BragaNux/IOT_N2/docs/Trabalho_N2_Caderno_de_Projeto.docx

Faculdade Antonio Meneghetti · Sistemas de Informação

IoT (Internet das Coisas) · G0813 · Prof. Leonam V. Hemann · Turma AMF 2026-02

TRABALHO N2 — CADERNO DE PROJETO

Da ideia ao sistema: decidir, montar e justificar

Integrantes (pode ser em dupla) papéis: montagem · código · nuvem e painel · caderno e testes | Brayan Martins · Mell Campos
Desafio escolhido | B — ideia própria: Ninho, chocadeira inteligente
Link do repositório no GitHub | https://github.com/BragaNux/IOT_N2

# COMO USAR ESTE CADERNO

Este caderno é ao mesmo tempo o roteiro do projeto e a entrega. Ele leva o grupo, etapa por etapa, pelas decisões que todo sistema IoT precisa tomar. Em cada etapa vocês encontram:

- Entenda: um resumo do que já vimos em aula, para ajudar a decidir.
- Decidam: os campos que o grupo preenche. Toda escolha vem com o porquê.

# COMO VAI SER AVALIADO

Critério | Etapas | Pontos
Ideia, problema e requisitos medíveis | 0 e 1 | 1,5
Sentir, decidir e agir funcionando, com estado seguro | 2 e 3 | 2,0
Comunicação: MQTT com TLS e padrão de tópicos | 4 | 1,5
Histórico com consulta de resumo | 5 | 1,0
Painel com comando confirmado e alerta com cooldown | 6 | 1,5
Segurança aplicada e testada | 7 | 1,0
Extra com evidência | 8 | 0,5
Arquitetura, testes e apresentação | 11 | 1,0
Total | | 10,0

# ETAPA 0 — ESCOLHAM O DESAFIO

Escolham um caminho: um dos desafios prontos (opção A) ou uma ideia própria (opção B). Vale montar na placa ou no Wokwi.

## Opção A — Desafios prontos

Desafio | O problema | Kit sugerido | A decisão mais difícil
Geladeira de vacinas | O posto guarda vacinas a 2–8 °C e precisa provar, pelo histórico, que elas nunca saíram da faixa. | DHT · distância (porta) · buzzer | O que fazer com as leituras se a internet cair?
Silo de grãos | Grão úmido estraga. O ventilador liga quando precisa, e não há tomada no silo. | DHT · LED ou relé (ventilador) | Quanto tempo o ESP32 pode ficar acordado para a bateria durar?
Armário de empréstimo | Laboratório: registrar quem pegou cada equipamento e quando devolveu. | botões (senha) ou RFID · servo (trava) · distância | Como impedir que alguém abra o armário com um comando falso?
Poste inteligente da praça | Luz forte só com gente perto. A prefeitura vê e comanda todos os postes de um painel. | LDR · distância ou PIR · LEDs (PWM) | Como organizar os tópicos para 100 postes?

## Opção B — Criem a ideia de vocês

Escolham (ou sorteiem) um item de cada coluna e transformem em um produto. A restrição é o que deixa a ideia interessante: ela obriga a tomar decisões de rede, energia ou segurança.

Lugar | Sensor | Atuador | Restrição
escola · fazenda · hospital · fábrica · rua · supermercado · academia · casa de idoso · estacionamento · biblioteca | LDR · DHT11 · LM35 · PIR · ultrassônico · RFID · umidade do solo · potenciômetro · botão | LED · LED RGB · buzzer · servo · relé · motor DC | sem Wi-Fi · bateria de 1 ano · dado sensível (LGPD) · 1.000 unidades · usuário sem celular · até R$ 60 · tem que funcionar sem internet · decidir em menos de 1 s

Frase da ideia: "Para [quem], que sofre com [problema], o [nome do produto] sente [sensor], decide [regra] e age com [atuador], mesmo com [restrição]."

## Decidam

Desafio (A) ou ideia própria (B) | B — ideia própria. Lugar: fazenda · Sensor: DHT22 (temperatura e umidade) · Atuador: relé (aquecedor), além de servo, buzzer e LED · Restrição: tem que funcionar sem internet.

Por que esse problema importa? Quem ganha com a solução? - Frase da ideia

O pequeno produtor rural que cria galinhas caipiras choca ovos numa chocadeira caseira (caixa de isopor + lâmpada). O embrião precisa de 37,5 °C estáveis por 21 dias, umidade controlada e ovos virados várias vezes por dia. Algumas horas de superaquecimento ou uma lâmpada queimada à noite perdem a ninhada inteira, e o produtor só descobre no dia 21. No interior, a internet é instável, então o sistema não pode depender dela para funcionar.

Quem ganha: o produtor (menos ovos perdidos, sem acordar de madrugada para conferir) e quem compra os pintinhos. O histórico mostra em que dia e por quanto tempo a chocadeira saiu da faixa, o que explica uma eclosão ruim.

Frase da ideia: "Para pequenos produtores rurais, que perdem ninhadas inteiras quando a chocadeira esquenta ou esfria sem ninguém ver, o Ninho sente a temperatura e a umidade (DHT22), decide quando aquecer, quando virar os ovos e quando alarmar, e age com o aquecedor (relé), o virador (servo) e a sirene (buzzer + LED), mesmo sem internet."

# ETAPA 1 — PROBLEMA E REQUISITOS

## Entenda

- Requisito funcional diz o que o sistema faz. Modelo: "O dispositivo deve [ação] quando [condição], em até [tempo ou limite]."
- Requisito não funcional diz como e quanto: energia, custo, rede disponível, ambiente (frio, umidade), tempo de resposta.
- Um bom requisito é medível: "alarme se T > 8 °C por mais de 5 min", e não "alarme se esquentar".

## Decidam

Código | Requisito (o dispositivo deve...) | Como vamos comprovar
RF1 | Medir temperatura e umidade a cada 2 s, publicar a telemetria a cada 30 s e gravar 1 leitura por minuto no histórico, com data e hora. | Log do Serial (2 s), mensagens MQTT a cada 30 s e 1 registro por minuto no D1.
RF2 | Controlar o aquecedor: ligar o relé quando T < 37,3 °C e desligar quando T > 37,7 °C (histerese), em até 2 s. | No Wokwi: DHT22 em 37,0 °C → lâmpada acende; 37,5 °C → mantém; 37,8 °C → apaga.
RF3 | Alarmar (buzzer + LED) se T ficar fora de 36,5–38,5 °C por mais de 2 min. Se T ≥ 39,5 °C, alarmar na hora e forçar o aquecedor desligado. | DHT22 em 39,0 °C → cronometrar 2 min até o alarme; em 40 °C → alarme e relé desligado em até 2 s.
RF4 | Virar os ovos (servo 45° ↔ 135°) a cada 1 h, e parar automaticamente a partir do dia 19 do ciclo. | Log do Serial com horário de cada viragem; ajustar o dia do ciclo para 19 e conferir que o servo para.
RF5 | Gravar todas as leituras no histórico, inclusive as feitas sem internet (reenviadas ao reconectar), permitindo consultar mínima, máxima e média por hora. | Desligar o Wi-Fi por 2 min, religar e conferir no D1 que não há buraco de horário; rodar a consulta de resumo.

Código | Requisito não funcional (como e quanto) | Por que é importante neste problema
RNF1 | Funcionar sem internet: controle, viragem e alarme rodam no ESP32; leituras ficam guardadas por pelo menos 6 h. | Sítio no interior com 3G instável. O embrião não espera a rede voltar.
RNF2 | Precisão de ±0,5 °C e ±2–5 % de umidade (DHT22, e não DHT11, que tem ±2 °C). | A faixa ideal tem só ±0,5 °C; com um erro de 2 °C o controle ficaria cego.
RNF3 | Comunicação com TLS (MQTT 8883 e HTTPS), comandos autenticados e o ESP32 só aceita temperatura alvo entre 36,5 e 38,5 °C. | Um comando falso de "alvo = 42 °C" cozinharia a ninhada. A validação no próprio ESP32 é a última barreira.
RNF4 | Sobreviver à queda de energia: o dia do ciclo e a temperatura alvo ficam salvos na flash (NVS) e o sistema retoma sozinho ao religar. | Queda de luz é comum no interior. O ciclo tem 21 dias e não pode recomeçar do zero.

# ETAPA 2 — SENTIR E AGIR: COMPONENTES

## Entenda

- No kit o atuador é pequeno, mas representa algo real: o LED pode ser uma lâmpada (relé), o servo uma válvula ou trava, o buzzer uma sirene. Digam o que ele representa.
- Todo sensor falha um dia (DHT devolve NaN, fio solta). Decidam o estado seguro: o que o atuador faz quando a leitura é inválida.

## Decidam

Componente | Mede ou aciona o quê | GPIO | Faixa ou limite | Se falhar, o sistema...
DHT22 | Temperatura e umidade dentro da chocadeira | 15 (SDA) | −40 a 80 °C (±0,5 °C) · 0–100 % UR · alvo 37,5 °C e 50–55 % UR (65–70 % nos dias 19–21) | 3 leituras inválidas seguidas (~6 s) → FALHA_SENSOR: aquecedor DESLIGADO, LED pisca rápido, bipe a cada 5 s e alerta. Esfriar um pouco é menos grave que superaquecer.
Relé + lâmpada (LED laranja) | Aciona o aquecedor (lâmpada incandescente de verdade) | 26 (IN) | Liga < 37,3 °C · desliga > 37,7 °C · corte forçado ≥ 39,5 °C | Estado seguro = DESLIGADO (ao ligar o ESP32, em falha do sensor e em superaquecimento). Lâmpada queimada aparece como temperatura caindo → alarme de frio.
Servo | Representa o virador da bandeja de ovos | 13 (PWM) | 45° ↔ 135° a cada 1 h · parado a partir do dia 19 | Se travar, os ovos ficam parados (dano lento, de horas). Não para o aquecimento; o horário da última viragem aparece no painel.
Buzzer | Representa a sirene | 23 | ~2 kHz · contínuo = temperatura · bipe a cada 5 s = falha de sensor | Falha não detectável pelo ESP32 → redundância: LED + alerta remoto.
LED vermelho + 220 Ω | Luz de alarme na chocadeira | 4 | Aceso = alarme · piscando = falha de sensor | Se queimar, o buzzer e o alerta remoto continuam avisando.

# ETAPA 3 — ONDE DECIDIR: ESP32 OU NUVEM?

## Entenda

Pergunta | Se a resposta for sim, a decisão tende a ir para...
Precisa reagir em menos de 1 segundo? | ESP32 (borda): não depende da rede
Tem que funcionar se a internet cair? | ESP32 (borda)
A regra muda com frequência ou é ajustada por alguém de fora? | Nuvem (Worker), ou limite guardado no KV e lido pelo ESP32
Precisa cruzar dados de vários dispositivos? | Nuvem
O dado é sensível e não deveria sair do local? | ESP32 (borda): envie só o resultado

Histerese: use dois limites (liga em 8 °C, desliga em 7 °C) para o atuador não ficar ligando e desligando quando o valor oscila perto do limite.

## Decidam

Regra de decisão em pseudocódigo (com histerese ou tempo mínimo)

ex.: se T > 8 por 5 min → alarme = ligado; se T < 7 → alarme = desligado

a cada 2 s:

T, UR = ler DHT22

se inválida 3x seguidas → FALHA_SENSOR;

aquecedor = DESLIGADO

# aquecedor (histerese em volta de 37,5)

se T ≥ 39,5 → aquecedor = DESLIGADO;

alarme = LIGADO (imediato)

senão se T < 37,3 → aquecedor = LIGADO

senão se T > 37,7 → aquecedor = DESLIGADO

(entre 37,3 e 37,7: mantém)

# alarme com tempo mínimo + histerese

se T < 36,5 ou T > 38,5 por ≥ 2 min

→ alarme = LIGADO

se 37,0 ≤ T ≤ 38,0 → alarme = DESLIGADO

# umidade: só aviso (o produtor põe água)

se UR fora da faixa do dia por ≥ 10 min

→ aviso "umidade"

a cada 1 h: se dia < 19 → servo alterna 45°/135°

buzzer = (alarme ou FALHA_SENSOR) e não silenciado
Onde a regra roda e por quê | No ESP32 (borda). Aquecer, cortar o superaquecimento e virar os ovos não podem depender da internet do sítio, e o corte em 39,5 °C precisa acontecer em segundos. A temperatura alvo e o dia do ciclo podem ser ajustados pelo painel; o ESP32 valida o valor recebido (só aceita 36,5–38,5 °C) e salva na flash (NVS). Se nunca receber nada, usa os padrões do código. A nuvem (Worker) fica com o que precisa de visão geral: histórico, resumo por hora e painel.
O que acontece se a internet cair? E quando ela voltar? | Durante a queda: nada muda no controle: aquecedor, viragem e alarme continuam. Cada leitura vai para um buffer circular no ESP32 (1 por minuto, 360 posições = 6 h), com o horário do relógio interno sincronizado por NTP. O broker publica o LWT "offline" e o painel mostra a chocadeira como desconectada. Quando volta: o ESP32 reconecta com espera crescente (1 s, 2 s, 4 s… até 60 s), publica "online" e envia o lote guardado ao Worker por HTTPS, em ordem e marcado como "atrasada": true. Só apaga do buffer depois do 200 OK.

# ETAPA 4 — COMUNICAR: PROTOCOLO, TÓPICOS E MENSAGEM

## Entenda

Protocolo | Bom para | Cuidado
MQTT | Muitos dispositivos, publicar e assinar, comandos em tempo real | Broker público: quem souber o tópico lê e publica
HTTP (Worker) | Gravar no KV/D1 e consultar o histórico | ESP32 pergunta; a nuvem não consegue "chamar" o ESP32
WebSocket | Painel no navegador atualizando sozinho | A conexão precisa ficar aberta

Padrão de tópicos: sis1a/<grupo>/<local>/telemetria, …/estado, …/comando, …/alerta. Minúsculas, sem acento, unidade no nome do campo (temp_c, dist_cm).

## Decidam

Protocolo(s) escolhido(s) e por quê | MQTT com TLS (porta 8883) entre o ESP32 e o broker público broker.hivemq.com, para telemetria, estado, alertas, comandos e acks em tempo real. Publicar/assinar combina com comando remoto e o broker é grátis. HTTPS para o Worker só para gravar o histórico no D1: o ESP32 manda as leituras em lote, com token, e isso funciona também para reenviar o que ficou guardado durante uma queda. WebSocket com TLS (porta 8884) no painel: o navegador recebe as mensagens MQTT na hora, sem recarregar a página.
Árvore de tópicos (todos) um por linha, dizendo quem publica e quem assina | sis1a/ninho/chocadeira1/telemetria → ESP32 publica a cada 30 s · painel assina sis1a/ninho/chocadeira1/estado → ESP32 publica (retido) "online"; o LWT publica "offline" se ele cair · painel assina sis1a/ninho/chocadeira1/alerta → ESP32 publica quando um alarme começa (com cooldown) · painel assina sis1a/ninho/chocadeira1/comando → painel publica (assinado com HMAC) · ESP32 assina sis1a/ninho/chocadeira1/ack → ESP32 publica a confirmação de cada comando · painel assina
JSON de exemplo da telemetria | {"ts":1794356400, "temp_c":37.4, "umid_pct":52, "aquecedor":true, "alarme":false, "silenciado":false, "alvo_c":37.5, "dia":4, "estado":"NORMAL", "buffer":0, "sig":"9f2c…(HMAC-SHA256)"}
TLS: qual porta e como o ESP32 confere o servidor? lembrem: setInsecure() não confere | Porta 8883 no ESP32 e 8884 (WSS) no painel. O ESP32 usa WiFiClientSecure.setCACert() com os certificados raiz públicos gravados em certs.h e confere a cadeia e a validade do certificado do servidor — por isso só conecta depois de acertar o relógio por NTP. Não usamos setInsecure(). Evidência: com a raiz errada a conexão é recusada com "X509 - Certificate verification failed".

# ETAPA 5 — GUARDAR: O HISTÓRICO

## Entenda

| KV (chave-valor) | D1 (banco relacional)
Guarda | Um valor por chave: último estado, configuração, limite | Linhas e colunas: cada leitura é um registro
Consulta | Pela chave exata | SQL: filtros, médias, GROUP BY por hora
Use quando | Precisa só do valor mais recente ou de um ajuste remoto | Precisa responder perguntas sobre o passado

- Pensem também em por quanto tempo guardar. Se o dado é pessoal (quem entrou, quem pegou o equipamento), a LGPD pede que se guarde só o necessário, pelo tempo necessário.

## Decidam

KV, D1 ou os dois? Por quê? | Os dois. D1 guarda cada leitura para responder perguntas sobre o passado (SQL com GROUP BY por hora). KV guarda só o estado mais recente, para o painel abrir na hora mesmo antes da primeira mensagem MQTT.
Estrutura: tabela(s) e colunas, ou chaves | D1 · leituras(id, dispositivo, ts, temp_c, umid_pct, aquecedor, dia, estado, recebido_em) com UNIQUE(dispositivo, ts): reenviar o mesmo lote não duplica. KV · chave estado:chocadeira1 → JSON com a última leitura e "atrasada": true/false.
De quanto em quanto tempo grava? | 1 leitura por minuto vai para o buffer do ESP32 e é enviada ao Worker a cada minuto. Depois de uma queda, o buffer é esvaziado em lotes de 30 a cada 5 s. A telemetria MQTT (30 s) é só para o tempo real e não é gravada.
Consulta de resumo (SQL) e a pergunta que ela responde ex.: temperatura máxima por hora nas últimas 24 h | Pergunta: em quais horas a chocadeira saiu da faixa e por quantos minutos? SELECT strftime('%Y-%m-%d %H:00', ts, 'unixepoch', '-3 hours') AS hora, MIN(temp_c), MAX(temp_c), AVG(temp_c), AVG(umid_pct), SUM(temp_c < 36.5 OR temp_c > 38.5 OR temp_c IS NULL) AS minutos_fora, 100.0 * AVG(aquecedor) AS pct_aquecedor FROM leituras WHERE dispositivo = ? AND ts >= agora - 24 h GROUP BY hora ORDER BY hora DESC;
Por quanto tempo guardar? Há dado pessoal? | 180 dias (cerca de 8 ciclos de 21 dias), apagados por um cron diário no próprio Worker. Não há dado pessoal: só temperatura, umidade e estado de uma máquina, então a LGPD não se aplica; mesmo assim guardamos só o necessário.

# ETAPA 6 — MOSTRAR E COMANDAR: O PAINEL

## Entenda

- Comando enviado não é comando executado. O painel só mostra "executado" quando o ESP32 devolve uma confirmação (ack). Se o ESP32 estiver dormindo ou offline, o painel tem que deixar isso claro.
- Um alerta que chega 30 vezes por minuto é ignorado. Usem um cooldown: o mesmo alerta não se repete antes de um tempo mínimo.

## Decidam

O que o painel mostra (estado, gráfico, resumo) | ESP32 online/offline (pelo LWT), temperatura, umidade, aquecedor, estado, dia do ciclo, alvo e se a mensagem é autêntica (assinatura); gráfico das últimas 6 h (D1 + tempo real) com a faixa 36,5–38,5 °C; resumo por hora das últimas 24 h (SQL); lista de alertas e de comandos.
Comando remoto: qual, por qual tópico ou rota | Tópico sis1a/ninho/chocadeira1/comando (MQTT, QoS 1): alvo (36,5–38,5 °C), dia do ciclo, silenciar 10 min e virar os ovos agora. O JSON leva id, horário e assinatura HMAC-SHA256.
Como o painel sabe que o comando foi executado? Quanto tempo espera? | O ESP32 executa e publica em …/ack o mesmo id com "executado" ou "recusado: motivo", também assinado. O painel espera até 10 s: sem ack, mostra "sem resposta (ESP32 offline?)".
Alerta: quando dispara, por onde chega e qual o cooldown | Quando um alarme começa: superaquecimento (na hora), temperatura alta/baixa (depois de 2 min), falha do sensor e umidade fora da faixa (10 min). Chega pelo tópico …/alerta e aparece no painel e como notificação do navegador. Cooldown de 10 min por tipo no ESP32 (60 s no modo demonstração) e de 1 min na tela.
Polling ou WebSocket? Por quê? | WebSocket para o tempo real: alarme de chocadeira não pode esperar o próximo polling. O histórico e o resumo vêm do Worker por fetch quando o painel abre e a cada 60 s.

# ETAPA 7 — PROTEGER: SEGURANÇA

## Entenda

Os cinco buracos que vimos na Estação Cofre. Para cada um, digam se ele existe no sistema de vocês e como foi fechado.

Buraco | Existe no nosso sistema? | Como fechamos (camada)
1. MQTT sem TLS (porta 1883) | Não. | ESP32 na porta 8883 e painel em WSS 8884 (transporte).
2. setInsecure() no HTTPS | Não. | setCACert com as raízes de certs.h, nos dois clientes (MQTT e HTTPS). Testado: raiz errada → conexão recusada (transporte).
3. Rota de gravação aceita qualquer um | Fechado. | POST /api/leituras exige "Authorization: Bearer DEVICE_TOKEN" (comparado em tempo constante), valida faixas e limita o lote a 100; as rotas de leitura exigem a PAINEL_KEY. Testado: sem token → 401 (aplicação, Worker).
4. Tópico de comando aberto | Existia: o broker é público, qualquer um publica. | Fechado na aplicação: o comando vai assinado com HMAC-SHA256; o ESP32 recusa assinatura errada, comando com mais de 120 s (replay) e id repetido, e ainda valida a faixa do valor (alvo 36,5–38,5). Telemetria e ack também são assinados (ESP32).
5. Segredo no GitHub ou no Serial | Não. | secrets.h fica no .gitignore (o repositório só tem o secrets.example.h); DEVICE_TOKEN e PAINEL_KEY são secrets do Worker na Cloudflare; o Serial não imprime tokens (configuração).

# ETAPA 8 — EXTRA: ESCOLHAM UM

Extra | O que fazer | Evidência no caderno
Energia e autonomia | Deep sleep e cálculo de quanto a bateria dura | Corrente média = Σ (corrente × tempo) ÷ período; autonomia = capacidade útil ÷ corrente média
Tempo real | Painel atualizado por WebSocket, sem recarregar | Print ou vídeo curto do painel mudando sozinho

## Decidam

Extra escolhido e por que combina com o problema | Tempo real (WebSocket). Numa chocadeira o que importa é saber na hora que a temperatura saiu da faixa: o painel recebe telemetria, alertas e acks pelo broker sem recarregar.
Evidência (cálculo, print ou comparação) | Print do painel com o selo "tempo real: WebSocket TLS", os valores mudando sozinhos e o comando passando de "enviado" para "executado" (pasta docs/prints do repositório).

# ETAPA 9 — ARQUITETURA FINAL

Descrevam o sistema em quatro camadas. Se quiserem, colem também um desenho ou print do esquemático (Wokwi, Fritzing ou foto da montagem).

Camada | O que tem nela no nosso sistema
Dispositivo | ESP32 com DHT22, relé (aquecedor), servo (virador), buzzer e LED. Controle na borda: histerese 37,3–37,7 °C, corte em 39,5 °C, estado seguro (aquecedor desligado) e buffer de 6 h. Alvo e dia do ciclo na flash.
Rede | Wi-Fi; MQTT com TLS 8883 no broker.hivemq.com; HTTPS para o Worker; NTP para a hora; HMAC nas mensagens.
Nuvem | Cloudflare Worker "ninho" (plano Free): POST /api/leituras (token), GET /api/estado, /api/leituras e /api/resumo (chave); D1 com o histórico; KV com o último estado; cron diário de retenção.
Interface | Painel web servido pelo próprio Worker: WebSocket WSS 8884, gráfico, resumo SQL, comandos com ack e alertas.

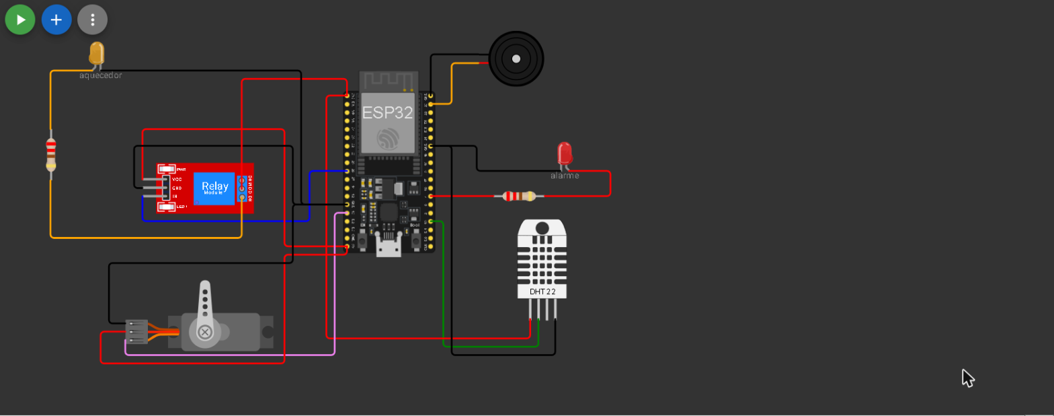
[picture p2: figure]

Desenho ou print do sistema cole aqui a imagem

# ETAPA 10 — TESTES ANTES DE APRESENTAR

Teste | Como fizemos | Resultado
Isolado: cada peça sozinha | Cada parte testada separada no Wokwi: DHT22 (leitura a cada 2 s no Serial), relé + lâmpada (liga/desliga pela histerese), servo (45° ↔ 135° a cada 30 s no modo DEMO), buzzer + LED (alarme). Depois, a rede: Wi-Fi + NTP, MQTT com TLS, HTTPS para o Worker (curl/navegador: 200 com token, 401 sem) e o painel sozinho. | Tudo respondeu. Serial: "MQTT conectado (certificado do broker conferido)", "historico: 1 leitura(s) gravada(s) no Worker". Worker recusa token errado (401). Prints 01 e 06.
No limite: forçar o sensor | Mexemos no DHT22 do Wokwi: 37,0 °C (aquecedor deve ligar), 37,8 °C (desligar), 39,0 °C (alarme depois do tempo), 40 °C (corte) e alvo inválido (a42 no Serial, fora de 36,5–38,5 °C). | Histerese funcionou (liga < 37,3, desliga > 37,7). Em 40 °C: estado SUPERAQUECIMENTO, relé desligado e alarme na hora. Alvo fora da faixa foi rejeitado ("REJEITADO") e o alvo antigo foi mantido. Prints 02, 03 e 05.
Na falha: tirar o sensor ou o Wi-Fi | Sensor: comando "f" no Serial simula o DHT22 sem leitura. Wi-Fi: comando "w" desliga o Wi-Fi por ~2 min e liga de novo. | Sensor: estado FALHA_SENSOR, aquecedor desligado por segurança e alerta "falha_sensor" no painel (prints 04, 08 e 09). Wi-Fi: o controle continuou, o painel mostrou "ESP32 sem telemetria" (print 10), as leituras foram para o buffer e, ao voltar, "historico: 3 leitura(s) gravada(s)". No D1: 11 leituras na última hora, 11 horários diferentes, sem buraco e sem duplicata (UNIQUE + INSERT OR IGNORE).
No reinício: tirar e ligar o USB | Reiniciamos a simulação várias vezes (equivale a tirar e ligar a energia) com a chocadeira em funcionamento. | O ESP32 volta com o aquecedor desligado (estado seguro), relê o sensor, reconecta sozinho (Wi-Fi → NTP → MQTT → ONLINE) e retoma o histórico. Alvo e dia do ciclo ficam na flash (Preferences); no Wokwi a flash é zerada a cada nova simulação.
No ataque: comando falso | Publicamos direto no tópico de comando, sem o painel: (1) alvo 39,9 °C com assinatura falsa; (2) comando com assinatura certa mas de 10 min atrás; (3) um comando válido enviado duas vezes (replay). | O ESP32 recusou os três: "assinatura invalida", "comando expirado" e "comando repetido"; só a primeira cópia do comando válido foi executada (print 11). TLS com certificado conferido impede ler/alterar no caminho.
Na duração: 10 min ligado | Deixamos o sistema rodando mais de 10 min (tempo simulado) com o painel aberto, mandando comandos e gravando no Worker. | Sem travar nem reiniciar, memória livre estável (~130 kB). O primeiro envio HTTPS leva ~14 s (aperto de mão TLS conferindo o certificado); com a conexão reaproveitada (keep-alive) os seguintes levam ~0,7 s.

# ETAPA 11 — APRESENTAÇÃO E ENTREGA

## Roteiro da apresentação (4 minutos)

1. Problema e quem usa (a frase da ideia).
2. Arquitetura: do sensor ao painel.
3. Escolhas: onde decide, qual protocolo, KV ou D1, que segurança. Por quê.
4. Demonstração ao vivo, funcionando.
5. O que falta para virar produto (1.000 unidades, bateria, custo).

A turma pode perguntar: "e se a internet cair?" · "e se alguém publicar no seu tópico?" · "e com 1.000 unidades?"

## Checklist de entrega (até 24/11)

| Item
☐ | Este caderno preenchido (.docx ou PDF) na pasta docs/ do repositório e no Classroom
☒ | Código do ESP32 e do Worker no GitHub, sem senhas nem chaves
☒ | README curto: o que o sistema faz, como montar e como testar
☒ | Print ou vídeo curto do sistema funcionando (para o caso de falhar na hora)

IoT · Trabalho N2 · Caderno de Projeto · página 1 de 8
