BragaNux/IOT_N2/docs/prints/02-aquecedor-liga-37C.png

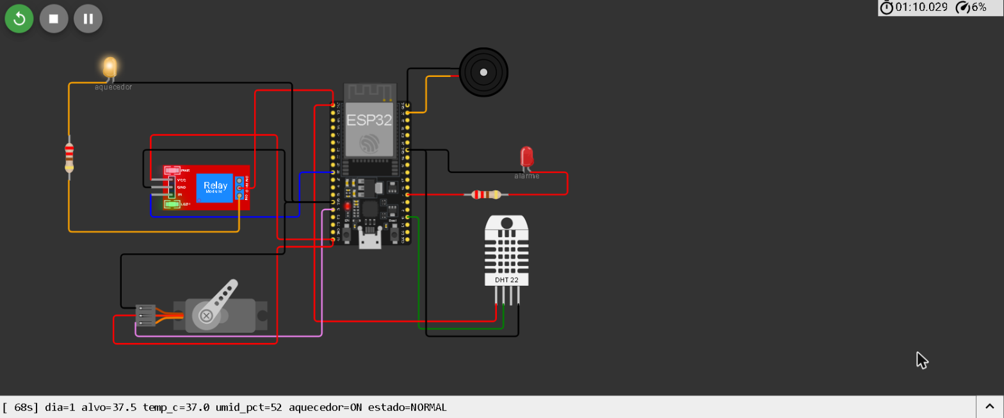
docs/prints/02-aquecedor-liga-37C.png
