BragaNux/IOT_N2/docs/prints/03-superaquecimento-40C.png

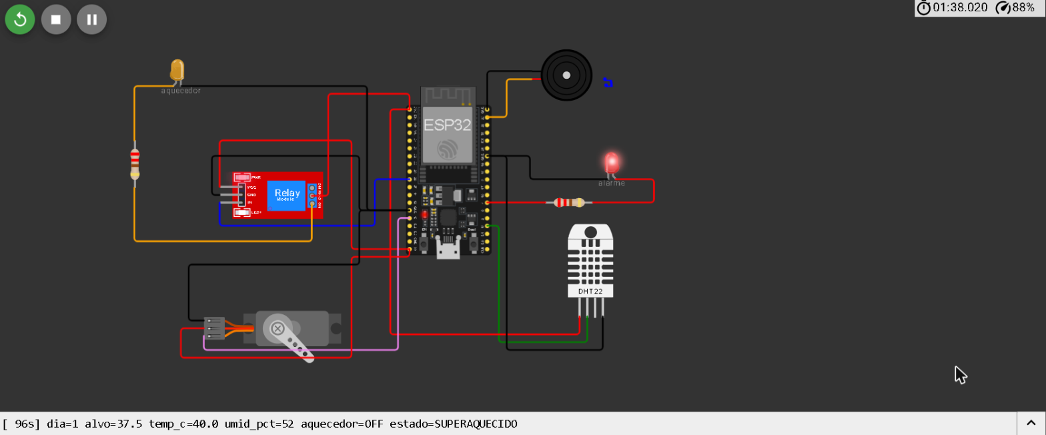
docs/prints/03-superaquecimento-40C.png
