BragaNux/IOT_N2/docs/prints/04-falha-sensor-estado-seguro.png

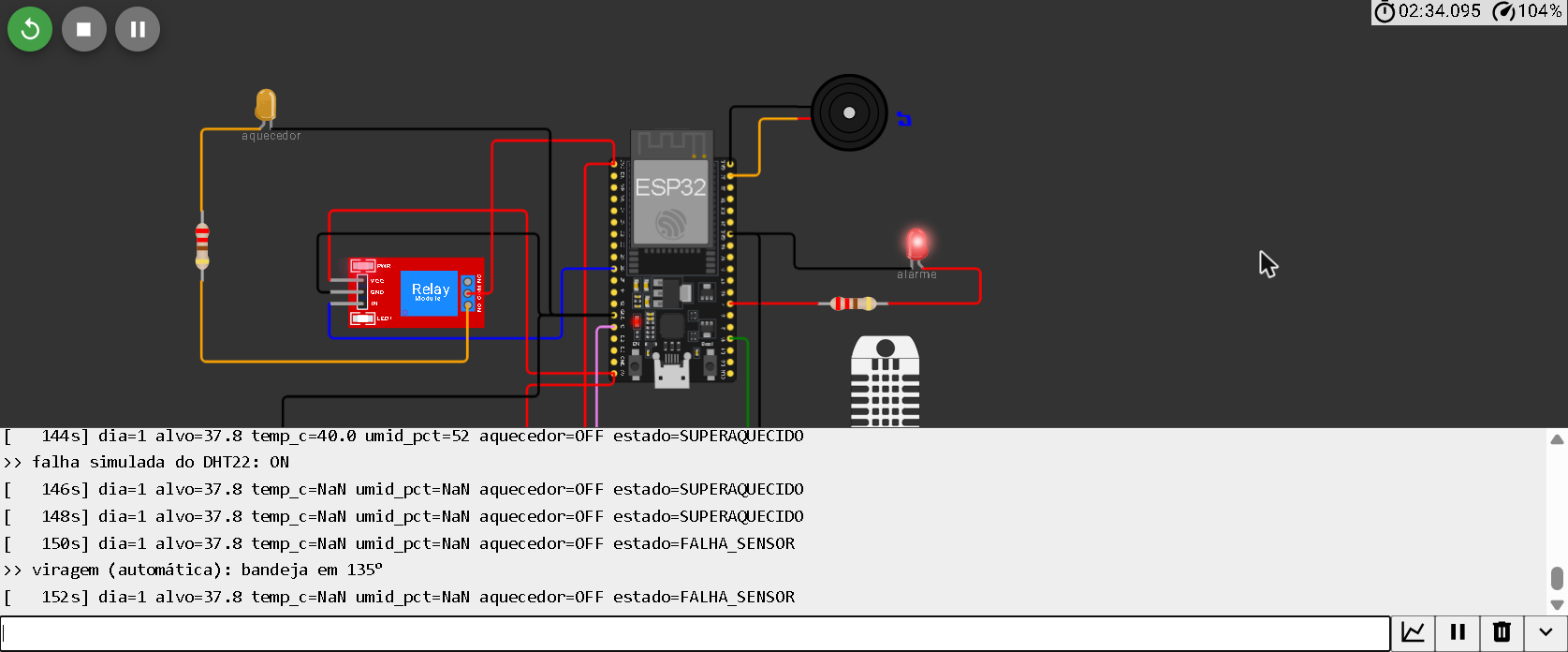
docs/prints/04-falha-sensor-estado-seguro.png
