BragaNux/IOT_N2/docs/prints/05-comando-invalido-rejeitado.png

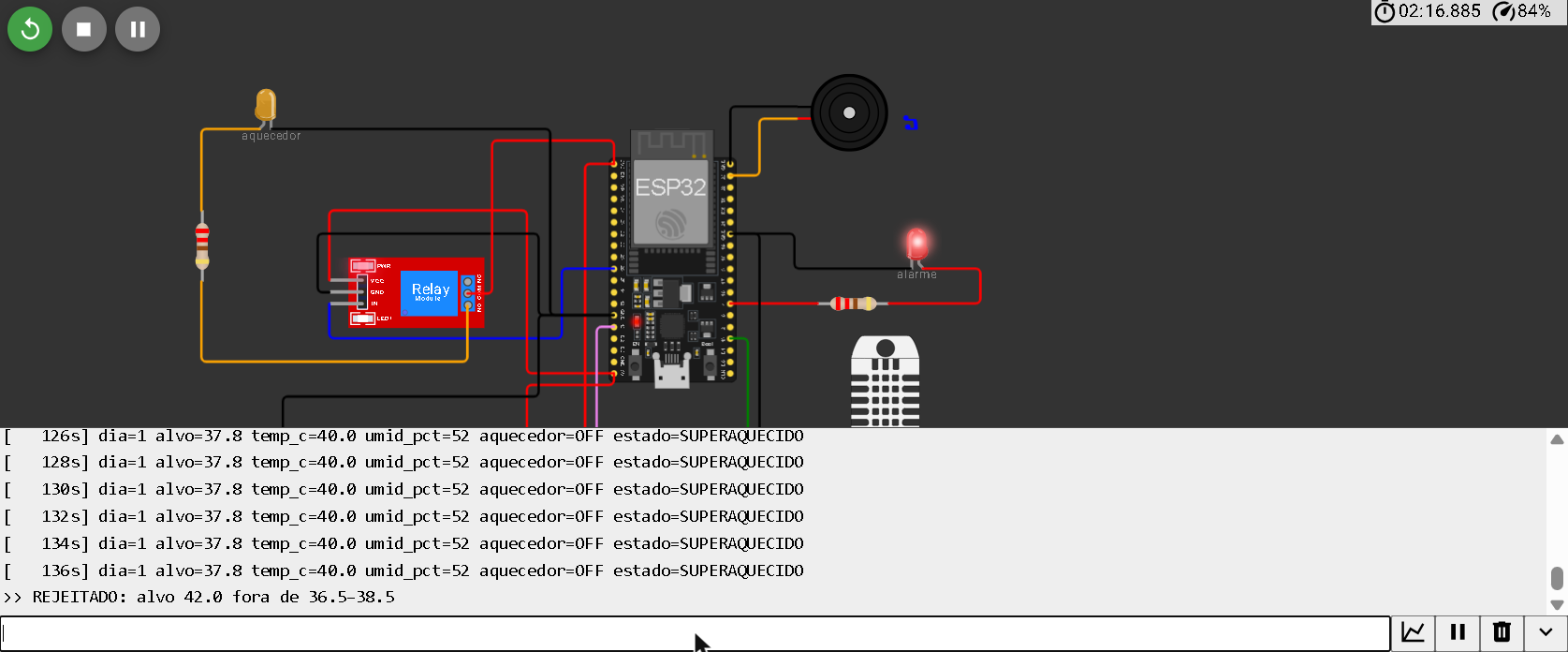
docs/prints/05-comando-invalido-rejeitado.png
