BragaNux/IOT_N2/docs/prints/06-painel-tempo-real.jpg

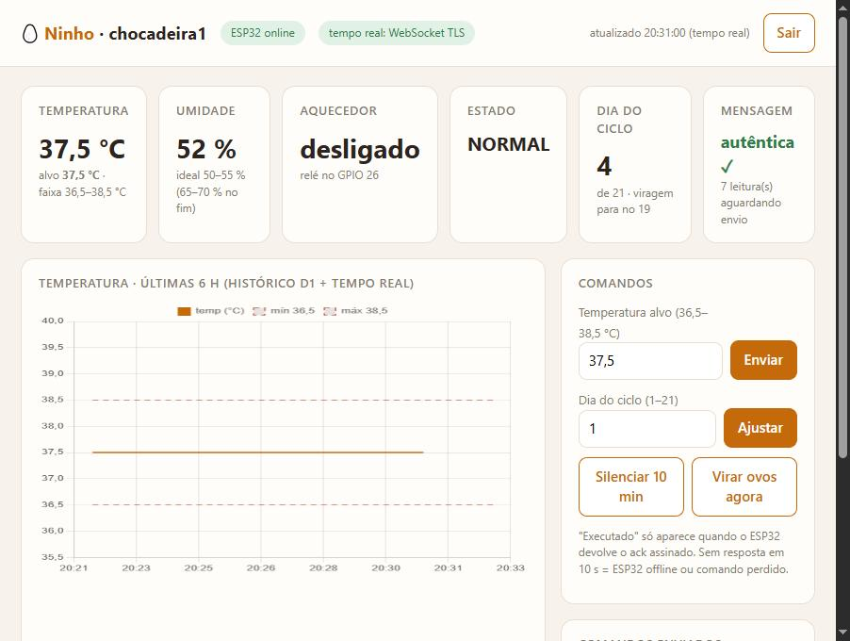
docs/prints/06-painel-tempo-real.jpg
