BragaNux/IOT_N2/docs/prints/07-comando-ack-executado.jpg

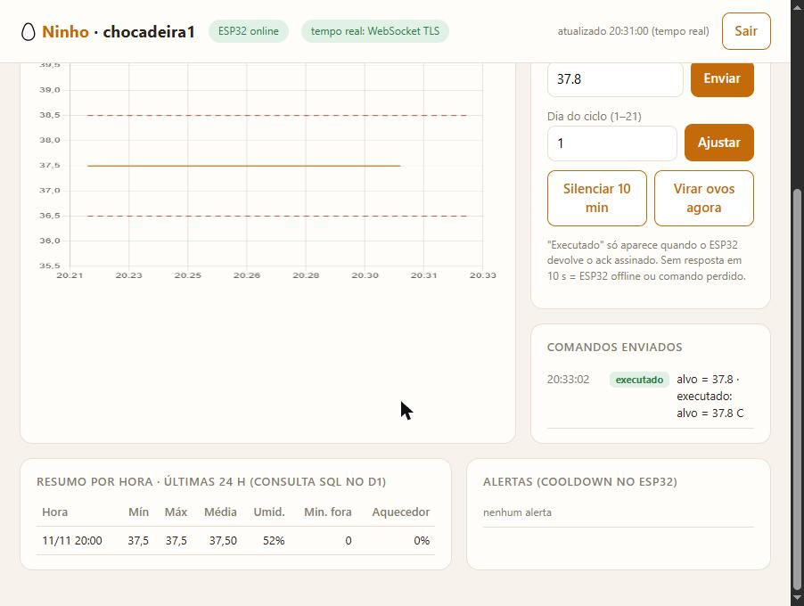
docs/prints/07-comando-ack-executado.jpg
