BragaNux/IOT_N2/docs/prints/08-painel-falha-sensor.jpg

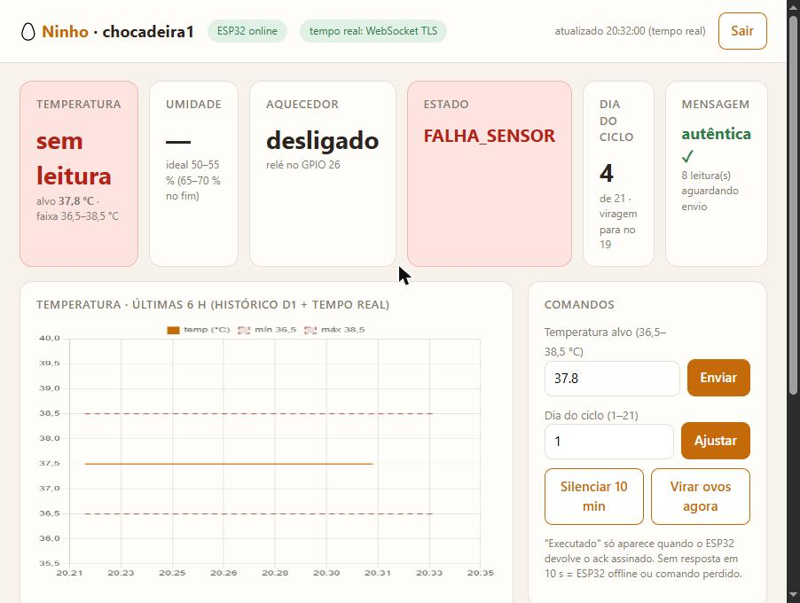
docs/prints/08-painel-falha-sensor.jpg
