BragaNux/IOT_N2/docs/prints/09-painel-alerta-resumo-sql.jpg

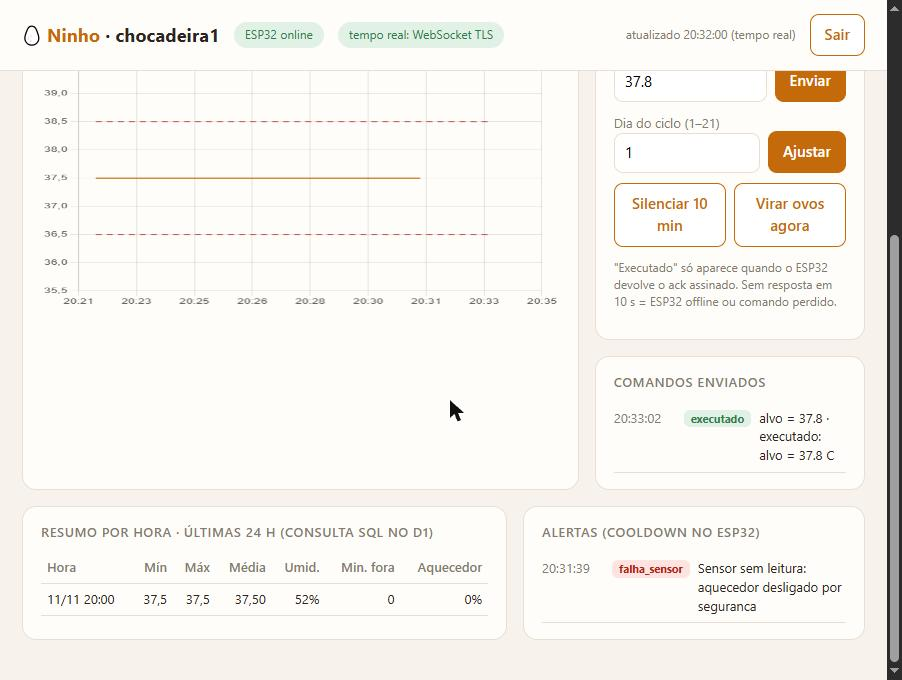
docs/prints/09-painel-alerta-resumo-sql.jpg
