BragaNux/IOT_N2/docs/prints/10-painel-esp32-sem-internet.jpg

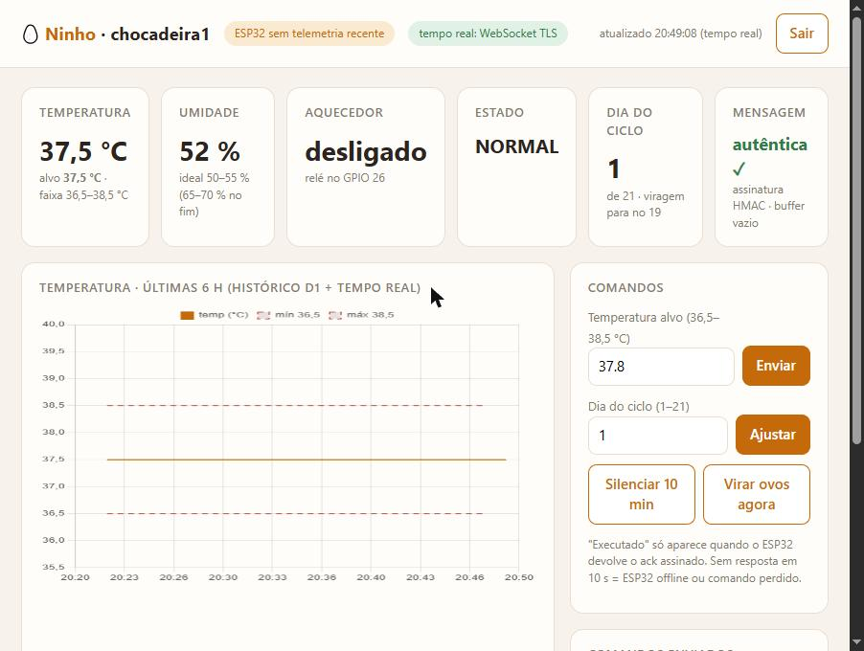
docs/prints/10-painel-esp32-sem-internet.jpg
