BragaNux/IOT_N2/docs/prints/11-ataque-comandos-recusados.png

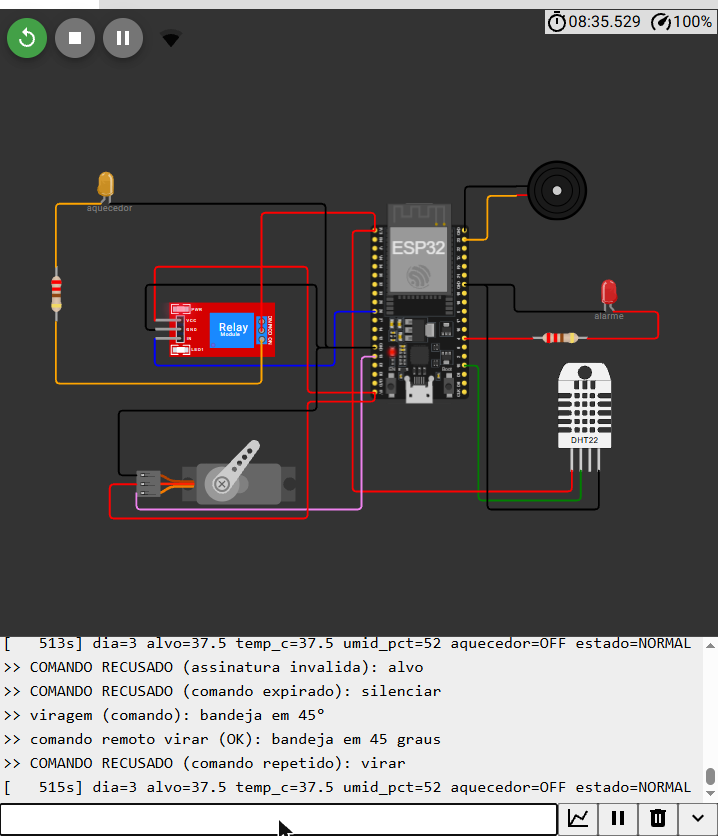
docs/prints/11-ataque-comandos-recusados.png
