BragaNux/IOT_N2/(commit log)

2026-11-10 Circuito organizado no Wokwi e print do circuito
2026-11-11 Firmware com MQTT/TLS e HMAC, Worker (D1 + KV), painel em tempo real e prints dos testes
2026-11-11 Firmware: reconexao de Wi-Fi mais paciente
2026-11-11 Caderno com etapas 4 a 9, diagrama de arquitetura e README completo
2026-11-11 Broker test.mosquitto.org (TLS 8886 e WSS 8081, Let's Encrypt)
    [certs.h, sketch.ino]
2026-11-11 Firmware: evita reset por watchdog no handshake TLS e fixa o fuso
    [sketch.ino]
2026-11-11 Firmware: tarefa de rede no nucleo 1 (sem reset por watchdog)
    [sketch.ino]
2026-11-11 certs.h: intermediario YE1 para o handshake com o Worker caber no tempo
2026-11-11 Firmware: HTTPS persistente para o Worker (handshake 14 s so no primeiro envio, depois ~0,7 s); prints do painel
2026-11-11 Caderno: etapa 10 (testes) e 11 preenchidas; README e prints atualizados
